nandanandanaphani14/4x4-systolic-array-multiplier-with-address-generator-/README.md

INDEX :
SIMPLE_ACCEl folders contain design upto AGU and control unit following simple architecture 
folders named FULL_ACCEL contains accelarator with complete AXI BUS TILING AND ZERO PADDING FOR DIFFERENT MATRIX SIZES
