nandanandanaphani14/4x4-systolic-array-multiplier-with-address-generator-/4x4-systolic-array-multiplier-with-address-generator--SIMPLE_ACCEL_DOCS/4x4-systolic-array-multiplier-with-address-generator--SIMPLE_ACCEL_DOCS/README.md

CONTAINS USER DOCS 
ARCHITECTURE EXPLANATON HTML FILE HAS INTERACTIVE PAGE TO SHOW DATA FLOW AND MULTIPLICATION 
VERFICATION REPORT TO SHOW WHAT VERIFICATION STRATEGIES HAVE BEEN USED
