nandanandanaphani14/4x4-systolic-array-multiplier-with-address-generator-/verification_recheck/doc_backup_original/architecture_and_dataflow.ORIGINAL.html

Technical Reference · Design & Verification

# 4×4 Weight-Stationary Systolic Accelerator

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

Reading this as a PDF

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

## 1What the design does

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

It is a weight-stationary systolic array. That phrase describes the dataflow completely:

The dataflow in one sentence

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

### Key numbers

Property | Value | Set by
Array size | 4 rows × 4 columns = 16 processing elements | ROWS, COLS
Operand format | int8 (signed, −128…127) | DATA_W = 8
Accumulator format | int32 (signed) | PSUM_W = 32
Peak throughput | 16 multiply-accumulates per clock | array size
Compute throughput | 1 activation vector (4 MACs × 4 columns) per clock | no back-pressure
Result latency | 7 cycles from activation address to result on the bus | RESULT_LATENCY
Store latency | 8 cycles from activation address to write strobe | STORE_LATENCY
Job length | num_vectors + 19 cycles | controller FSM
Activation memory | 256 words × 32 bits (256 vectors) | A_ADDR_W = 8
Weight memory | 4 words × 32 bits (one word per weight row) | W_ADDR_W = 2
Output memory | 256 words × 128 bits | O_ADDR_W = 8

## 2Repository and module map

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

### The 13 RTL modules

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

Filename ≠ module name

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

### Instance hierarchy

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

## 3Architecture: the three levels

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

### Why three levels instead of one

#### They cannot drift apart

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

#### Failures localise instantly

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

#### Each level is independently usable

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

#### No file overwrites another

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

## 4Word formats and data layout

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

The mental model

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

None of the memories has a reset. Reads of unwritten addresses return X in simulation.

## 5The processing element

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

### The source

// combinational
product_ext = 32'(weight_q * a_in);            // signed × signed, sign-extended
adder_out   = psum_in + product_ext;

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

// outputs
a_out     = a_q;
valid_out = valid_q;
psum_out  = wload ? 32'(weight_q) : psum_q;    // combinational mux

### Three things worth understanding

#### The vertical bus is time-multiplexed

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

#### During wload, psum_out is combinational off weight_q

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

Rule 1 — weight rows load bottom-first

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

#### Valid gating is a bypass, not a stall

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

## 6delay_pipe — animated

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

DELAY = 0 is not a degenerate case to be tolerated

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

### The governing relation

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

dout(cycle m) == din(cycle m − DELAY)

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

cycle 0 DELAY = ▶ Play Step ▸ ↺ Reset dout(m) = din(m−3)

din — driven this cycle pipe stage (a flip-flop) dout — visible on the output now

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

## 7The input skew buffer — animated

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

### Why the delay has to be exactly r

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

S_ROWS(t₀ + ROWS) = Σ_r  w[r][c] · a_in_left[r](t₀ + r − c)

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

a_in_left[r](t₀ + r − c) = dense_a[r](t₀ − c)

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

cycle 0 ▶ Play Step ▸ ↺ Reset three dense vectors on cycles 1, 2, 3

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

## 8The systolic array

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

### Column latency

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

n + (ROWS−1) + c

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

## 9Matrix multiply, cycle by cycle — animated

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

### The problem being solved

#### Weight matrix W (stationary)

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

#### Activation vectors A (streamed)

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

C0 = [  -5   17   10   -3 ]
C1 = [   9   -7   21  -13 ]
C2 = [  -4   17   -9   12 ]

### The four phases

Phase | Cycles | What is happening
WLOAD | 1–4 | wload = 1. Weight rows are driven onto the north edge bottom-first: W[3], W[2], W[1], W[0]. The vertical bus is a downward shift register, so the first row fed travels furthest.
FLUSH | 5–10 | wload = 0, zeros on the north edge, valid = 0. The psum_q registers latched weight values during WLOAD; this pushes that residue out of the bottom.
COMPUTE | 11–13 | One dense activation vector per clock with valid = 1. A0 at cycle 11, A1 at 12, A2 at 13.
DRAIN | 14–21 | The last vector is still travelling through the array, the de-skew buffer and the packing logic. C0 lands after cycle 17, C1 after 18, C2 after 19.

IDLE cycle 0 ▶ Play ◂ Back Step ▸ ↺ Reset speed golden check: pending

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

### Reading the trace

- Cycles 1–4, the W-row column. The order is 3, 2, 1, 0. After cycle 4 every PE holds its correct weight — check the weight values in the animation against the W matrix above.
- Cycles 1–4, the bottom column. Weight values appear here. That is the residue the FLUSH phase exists to clear, and it is why the result bus must not be trusted until compute begins.
- Cycle 11. A0 enters. Only west[0] is live — rows 1, 2 and 3 are still inside their skew pipes.
- Cycle 14. bottom[0] becomes −5, which is C0[0]. That is 11 + (ROWS−1) + 0 = 14. ✓
- Cycles 15, 16, 17. bottom[1], bottom[2], bottom[3] follow one cycle apart — the staircase.
- Cycle 17. All four elements of C0 appear simultaneously on result. That is 11 + ROWS + COLS − 2 = 17. ✓ The de-skew delay COLS−1−c exactly cancels the array's +c.

Why FLUSH is belt-and-braces, and why it stays anyway

Strictly, FLUSH is not required for correctness. Partial sums march south at exactly one row per cycle, so weight residue and a real accumulation always occupy different pipeline slots — they can never mix. FLUSH exists so the result bus is visibly quiet before compute starts, which is what makes the "quiet before compute" assertions and the waveforms meaningful.

This is recorded explicitly so that a future reader neither deletes it as pointless nor treats it as untouchable.

## 10The output de-skew buffer

Twenty-four lines, and it does one thing: undo the +c staircase that section 8 derived.

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

## 11The memories

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

always_ff @(posedge clk) begin
    if (we) mem[addr] <= wdata;
    rdata <= mem[addr];
end

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

### Why this exact coding style matters

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

## 12Control plane: FSM and AGU

The control plane is split along one clean line, taken directly from the architecture diagram:

#### controller.sv — durations only

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

#### agu.sv — addresses only

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

### 12.1 The phase FSM

Figure 12.1 — the controller's six states. busy covers WLOAD…DRAIN. done is a single-cycle pulse fired in DONE, by which point busy is already low. start is sampled only in IDLE and is ignored while busy, so a stray pulse mid-job changes nothing.

The state register, counter and vector-count latch are the whole module:

PH_WLOAD:  if (cnt == VEC_CNT_W'(ROWS-1))          { cnt <= 0; state <= PH_FLUSH;   } else cnt++;
PH_FLUSH:  if (cnt == VEC_CNT_W'(FLUSH_CYCLES-1))  { cnt <= 0;
               state <= (vec_n == 0) ? PH_DRAIN : PH_COMPUTE;                     } else cnt++;
PH_COMPUTE:if (cnt == (vec_n - 1'b1))              { cnt <= 0; state <= PH_DRAIN;   } else cnt++;
PH_DRAIN:  if (cnt == VEC_CNT_W'(STORE_LATENCY-1)) { cnt <= 0; state <= PH_DONE;    } else cnt++;

Why num_vectors = 0 is handled explicitly

COMPUTE exits on cnt == vec_n - 1. With vec_n = 0 that comparison is against 8'hFF, so the FSM would sit in COMPUTE for 256 cycles issuing garbage addresses and 256 write strobes — actively corrupting memory. The one-line guard in FLUSH turns a malformed command from destructive into harmless. It costs one comparator.

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

### 12.2 The address generator

#### Weight address — counts down

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

#### Activation address — counts up

if (!compute_phase) act_cnt <= '0;
else                act_cnt <= act_cnt + 1'b1;
assign act_addr = act_base + act_cnt;

#### Output address and write strobe — a delay line, not a calculation

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

Structural guarantees beat computed ones

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

### 12.3 Port arbitration at level 3

Every SRAM is single-port, so exactly one master may drive it:

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

## 13Timing derivations

### Notation

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

### The chain, one step at a time

# | Step | Adds | Running total

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

### Summary of every latency constant

Constant | Value (4×4) | Formula | Declared in
Array column latency | 3 + c | (ROWS-1) + c | array.sv (emergent)
De-skew delay | 3 − c | COLS-1-c | output_skewbuf.sv
Level 1 result latency | 6 | ROWS + COLS - 2 | wrapper_array_buf.sv
Level 2 result latency | 7 | 1 + ROWS + COLS - 2 | wrapper_mem_arr_buf.sv
Level 2 store latency | 8 | RESULT_LATENCY + 1 | wrapper_mem_arr_buf.sv
AGU write-pipe depth | 8 | STORE_LATENCY | agu.sv
Controller DRAIN | 8 | STORE_LATENCY | controller.sv
Total job length | N + 19 | ROWS + FLUSH_CYCLES + N + STORE_LATENCY + 1 | emergent

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

### Why control is re-timed inside the wrapper

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

wload_q <= wload;
valid_q <= valid_in;

Rule 2 — control travels with its address

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

Rule 3 — fixed latency, no back-pressure

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

## 14End-to-end data flow

Putting all three levels together, here is the complete path a single number takes.

### A weight, from memory to its PE

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

### An activation, from memory to a result in memory

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

### Driving the design

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

Job length is num_vectors + 19 cycles. start is ignored while busy. num_vectors = 0 is legal and does not hang.

## 15Verification summary

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

### Method, in four points

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

### The three defects

# | Where | Cause

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

## 16Known limitations

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

vlog passing is not evidence the design builds

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

### Sensible next steps, in order of value

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
