nandanandanaphani14/4x4-systolic-array-multiplier-with-address-generator-/4x4-systolic-array-multiplier-with-address-generator--SIMPLE_ACCEL_DOCS/4x4-systolic-array-multiplier-with-address-generator--SIMPLE_ACCEL_DOCS/TESTBENCHES_visualised.html

RE-VERIFICATION · VISUAL GUIDE

# Testbenches, Visualised

How the re-verification suite exercises the 4×4 weight-stationary systolic accelerator — the test plan, the dataflow each testbench checks, the architecture it targets, and how a single testbench is structured. Companion to architecture_and_dataflow.html.

11 / 11 testbenches pass

3 680 checks

0 mismatches

0 RTL defects

QuestaSim 2021.1 · 2026-08-03

## 1The test plan — bottom-up coverage

The plan mirrors the module hierarchy from SIMPLE_ACCEL_TB/README.md: prove each leaf element, then close the system at three rising abstraction levels. Press Play to watch coverage climb the hierarchy — each level is only trusted once everything beneath it passes.

▶ Play coverage climb ↺ Reset idle

tb_processing_element

processing_element · MAC

1546

✔ PASS

tb_delay_pipe

delay_pipe (×12)

125

✔ PASS

tb_memories

a_mem · weight_mem · output_mem

88

✔ PASS

▲

tb_input_skew_buffer

dense → diagonal

957

✔ PASS

tb_output_deskew_buffer

staircase → aligned

482

✔ PASS

tb_systolic_array

4×4 PE fabric · golden C=A×W

28

✔ PASS

▲

tb_array_buf_top

LEVEL 1 · skew+array+deskew

54

✔ PASS

▲

tb_controller

phase FSM · durations

44

✔ PASS

tb_agu

address generator

34

✔ PASS

tb_accelerator_top

LEVEL 2 · + three SRAMs

73

✔ PASS

▲

tb_accelerator_system_top

LEVEL 3 · + FSM + AGU + arbitration · incl. two 4×4×4×4 multiplies

133

✔ PASS

A failure that appears only at a higher level is necessarily in the control plane, because everything beneath it is already proven independently.

## 2The flow each testbench checks

Every job runs the same four phases. The golden testbenches load a random non-symmetric weight matrix, stream activation vectors, and compare each result against C = A × W computed by a plain nested loop. This animation illustrates weights loading bottom-first, activations streaming as a diagonal wavefront, partial sums descending, and results emerging and de-skewing onto one cycle.

WLOAD4 cyc — skipped if weights unchanged

COMPUTEnum_vectors

DRAIN8 cyc

DONE1 cyc

Five phases, no FLUSH: COMPUTE follows WLOAD directly. Job length N + 13 = 17 cycles for a 4×4 product, or N + 9 = 13 cycles when the weight matrix has not changed since the last job and WLOAD is skipped altogether.

▶ Play Step ▸ ↺ Reset cycle 0 · IDLE

weight (stationary) activation (streams east) partial sum (descends south) aligned result

Illustrative dataflow (job length = num_vectors + 13 cycles). The cycle-accurate golden trace lives in architecture_and_dataflow.html §9.

## 3The architecture each testbench targets

The design closes at three levels, each wrapper instantiating the one below. Hover or tap a testbench chip to highlight the block it drives — leaf testbenches target one module; wrapper testbenches target a whole level.

LEVEL 3 — accelerator_system_top tb_accelerator_system_top

host interface · start / num_vectors / act_base / out_base · busy / done / phase

controller

phase FSM tb_controller

agu

addresses tb_agu

LEVEL 2 — accelerator_top tb_accelerator_top

+ three SRAMs, control re-timing, output packing

a_mem

tb_memories

weight_mem

tb_memories

output_mem

tb_memories

LEVEL 1 — array_buf_top tb_array_buf_top

skew buf

tb_input_skew_buffer

4×4 PE array

tb_systolic_array

de-skew

tb_output_deskew_buffer

PE cell & delay_pipe primitives tb_processing_element tb_delay_pipe

Because L3 instantiates L2 instantiates L1, the datapath verified at a lower level is byte-for-byte the datapath running inside the higher one — the levels cannot drift apart.

## 4How a single testbench is structured

All 11 testbenches share one reporting harness (tb_common.svh) and emit an identical, reviewable transcript. Press Replay to type one out; the anatomy is annotated below.

▶ Replay transcript idle

Banner

DUT, sampling convention, and a numbered TEST PLAN (T1, T2, …) — states up front what will be proven.

Decoded stimulus + trace

Each transaction prints inputs and the observed output beside the expected value, so a passing run is reviewable, not just green.

Section tally

Tx ends: N checks, M errors [PASS] — every section reports its own count.

Section summary + TOTALS

A table of all sections, a grand TOTALS, and a single RESULT: PASS/FAIL line the regression script greps.

Two sampling conventions

A (registered outputs): drive after a posedge, consume at the next, then sample. B (delay lines / address buses): sample before the consuming edge — the only way to tell a wire from a 1-deep register. Each header states which it uses.

Golden model

From the fabric up, expected values are C = A×W from a plain nested loop with a random non-symmetric matrix — a design bug copied into the testbench is impossible, and any weight-row permutation fails.

## 5Directed 4×4 × 4×4 matrix multiply (T5)

The L3 testbench streams four activation vectors — treating A as a full 4×4 matrix — and checks the whole product against the golden model. Press Compute to fill C = A × W cell by cell; each cell is C[i][c] = Σr A[i][r]·W[r][c].

▶ Compute C = A × W ↺ Reset idle

A (4×4)

×

W (4×4)

=

C (4×4)

Rows 0–2 of C reproduce weight rows 0–2; the all-ones activation row 3 yields the column sums [28 32 36 40] — checkable by eye, which is the point of a directed case.

Reproduce the regression: .\verification_recheck\testbenches\run_all_testbenches.ps1 — compiles the unmodified RTL + the 11 testbenches, runs each in QuestaSim batch mode, writes one transcript per testbench to verification_recheck\logs\, and exits non-zero on any failure.

See the full report at verification_recheck\verification_recheck_report.md and the segmented design context under context_mkdwn\.
